IntergalacticMicrosystems/Victor9000-RAM-r2/README.md

# Victor9000-RAM-r2

WORK IN PROGRESS ~ DO NOT USE YET

The Victor9000-RAM-r2 is an attempt to modernize the design for cheaper manufacturing.

Jumper JP1 open is for use on a 256k motherboard, and JP1 closed is for a 128k motherboard.
