IntergalacticMicrosystems/Victor9000-RAM-r2/Victor9000-RAM-r2.routed.png

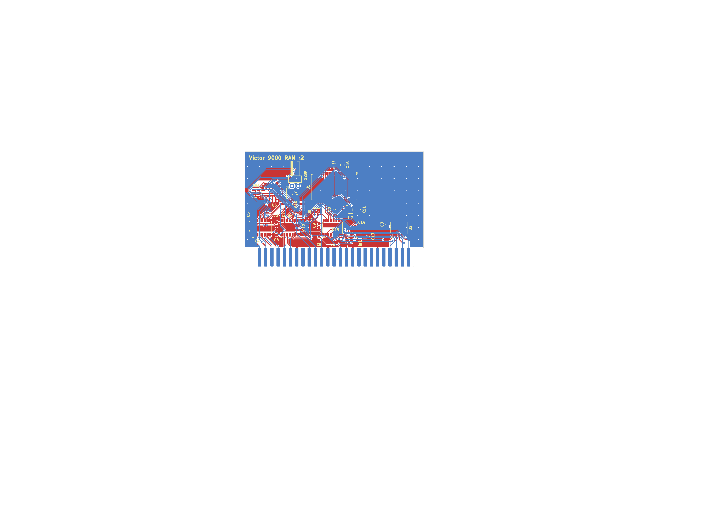
Victor9000-RAM-r2.routed.png
