IntergalacticMicrosystems/Victor9000-RAM-r2/Victor9000-RAM-r2.pdf

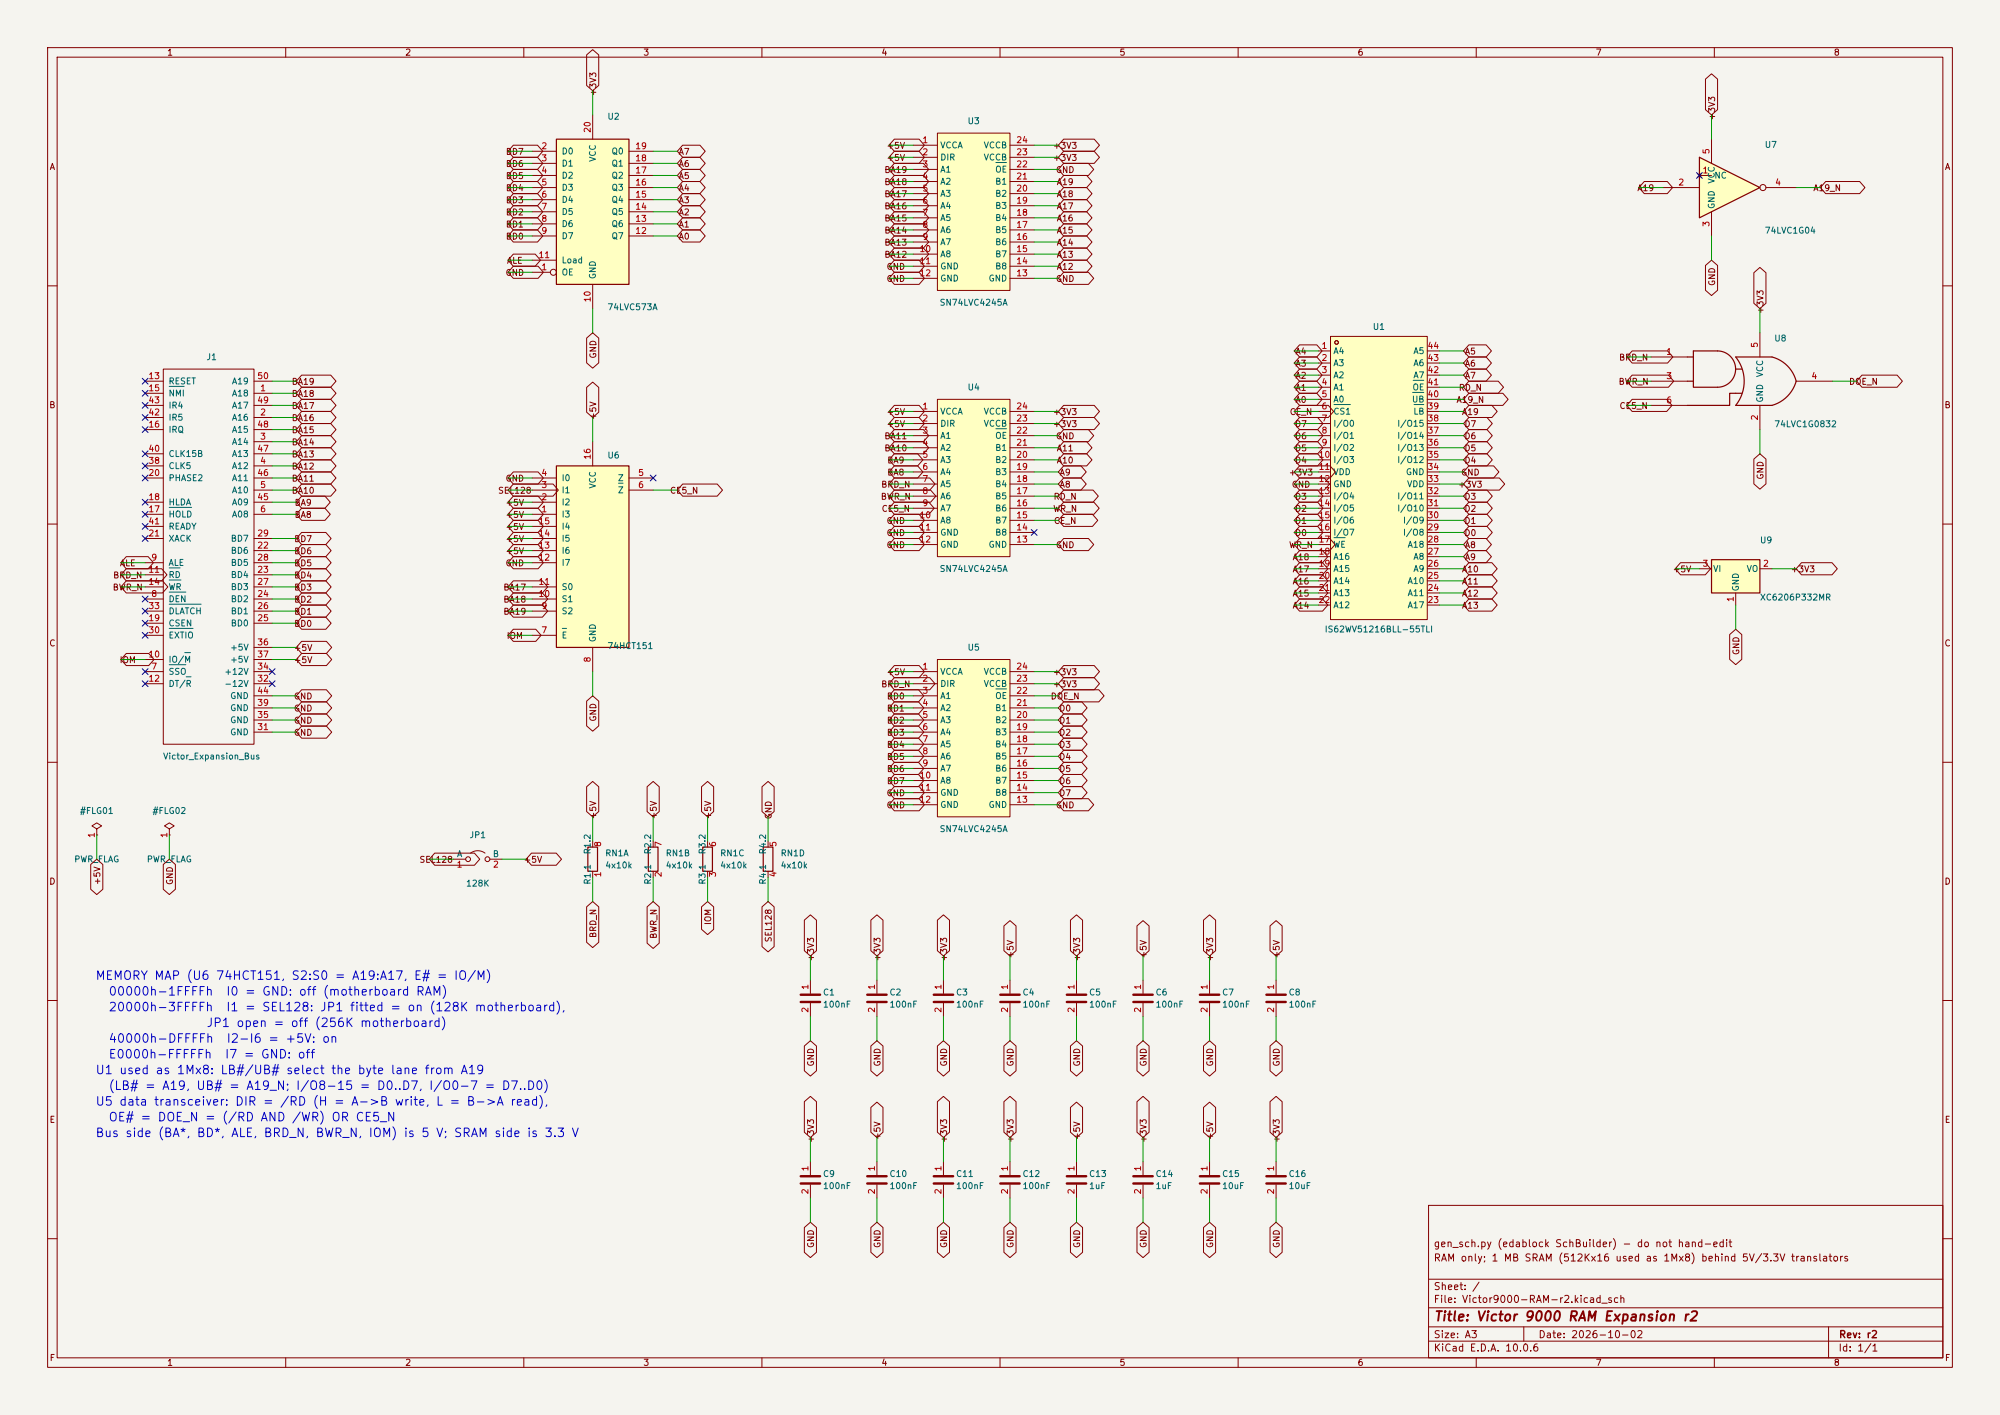
[picture p2: page 1]

MEMORY MAP (U6 74HCT151, S2:S0 = A19:A17, E# = IO/M)
00000h-1FFFFh I0 = GND: off (motherboard RAM)
20000h-3FFFFh I1 = SEL128: JP1 fitted = on (128K motherboard),

40000h-DFFFFh I2-I6 = +5V: on
E0000h-FFFFFh I7 = GND: off
U1 used as 1Mx8: LB#/UB# select the byte lane from A19
U5 data transceiver: DIR = /RD (H = A->B write, L = B->A read),
OE# = DOE_N = (/RD AND /WR) OR CE5_N
Bus side (BA*, BD*, ALE, BRD_N, BWR_N, IOM) is 5 V; SRAM side is 3.3 V

RAM only; 1 MB SRAM (512Kx16 used as 1Mx8) behind 5V/3.3V translators

Sheet: /
File: Victor9000-RAM-r2.kicad_sch
Title: Victor 9000 RAM Expansion r2

Size: A3 | Rev: r2 | F Date: 2026-10-02
KiCad E.D.A. 10.0.6 | Id: 1/1
