IntergalacticMicrosystems/Victor9000-RAM-r2/Victor9000-RAM-r2.kicad_pcb

## KiCad design Victor9000-RAM-r2.kicad_pcb (2026-10-10)

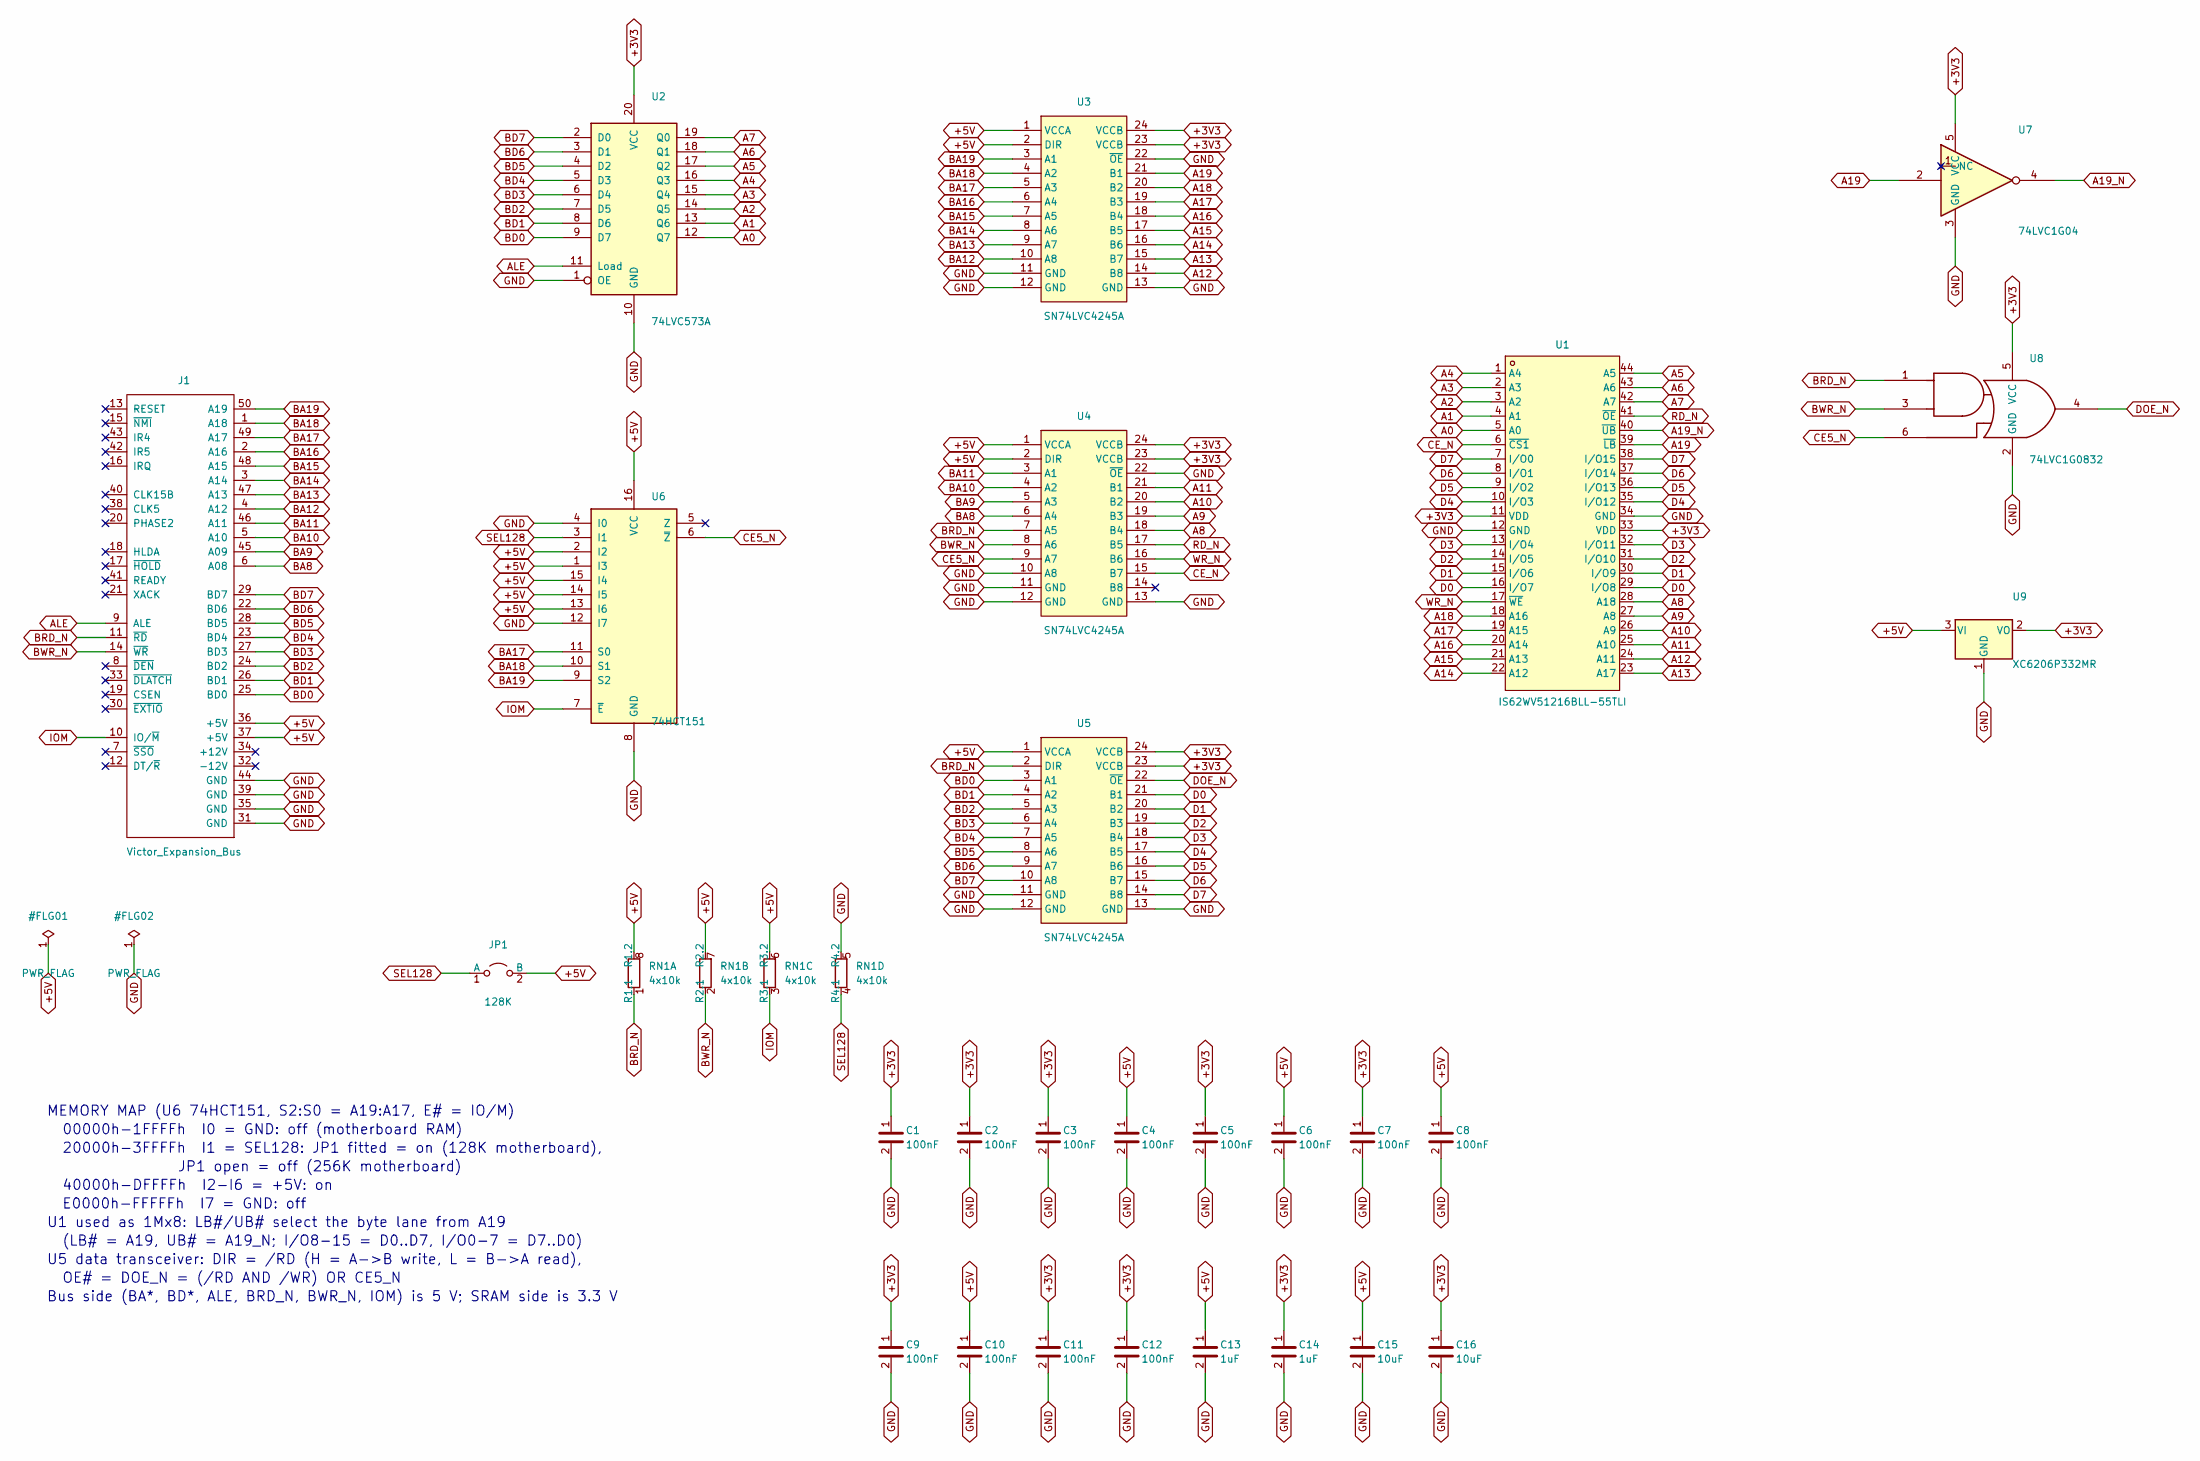
[picture p3: schematic Victor9000-RAM-r2.kicad_sch, Victor 9000 RAM Expansion r2]

Parts:
C1, C2, C3, C4, C5, C6, C7, C8, C9, C10, C11, C12: 100nF; C_0603_1608Metric; MPN CC0603KRX7R9BB104; LCSC C14663
C13, C14: 1uF; C_0603_1608Metric; MPN CL10A105KB8NNNC; LCSC C15849
C15, C16: 10uF; C_0805_2012Metric; MPN CL21A106KAYNNNE; LCSC C15850
J1: Victor_Expansion_Bus; Victor Expansion Edge Connector; MPN card-edge fingers
JP1: 128K; PinHeader_1x02_P2.54mm_Horizontal; MPN PZ254R-11-02P; LCSC C492410
RN1: 4x10k; R_Array_Convex_4x0603; MPN 4D03WGJ0103T5E; LCSC C29718
U1: IS62WV51216BLL-55TLI; TSOP-II-44_10.16x18.41mm_P0.8mm; MPN IS62WV51216BLL-55TLI; LCSC C11315
U2: 74LVC573A; TSSOP-20_4.4x6.5mm_P0.65mm; MPN 74LVC573APW,118; LCSC C6096
U3, U4, U5: SN74LVC4245A; TSSOP-24_4.4x7.8mm_P0.65mm; MPN SN74LVC4245APWR; LCSC C7859
U6: 74HCT151; SOIC-16_3.9x9.9mm_P1.27mm; MPN 74HCT151D,653; LCSC C547364
U7: 74LVC1G04; SOT-23-5; MPN SN74LVC1G04DBVR; LCSC C19829658
U8: 74LVC1G0832; SOT-23-6; MPN SN74LVC1G0832DBVR; LCSC C206101
U9: XC6206P332MR; SOT-23; MPN XC6206P332MR-G; LCSC C5446

Connections:
+3V3: C1.1, C2.1, C3.1, C5.1, C7.1, C9.1, C11.1, C12.1, C14.1, C16.1, U1.11 (VDD), U1.33 (VDD), U2.20 (VCC), U3.23 (VCCB), U3.24 (VCCB), U4.23 (VCCB), U4.24 (VCCB), U5.23 (VCCB), U5.24 (VCCB), U7.5 (VCC), U8.5 (VCC), U9.2 (VO)
+5V: C4.1, C6.1, C8.1, C10.1, C13.1, C15.1, J1.36 (+5V), J1.37 (+5V), JP1.2 (B), RN1.6 (R3.2), RN1.7 (R2.2), RN1.8 (R1.2), U3.1 (VCCA), U3.2 (DIR), U4.1 (VCCA), U4.2 (DIR), U5.1 (VCCA), U6.1 (I3), U6.2 (I2), U6.13 (I6), U6.14 (I5), U6.15 (I4), U6.16 (VCC), U9.3 (VI)
A0: U1.5 (A0), U2.12 (Q7)
A1: U1.4 (A1), U2.13 (Q6)
A2: U1.3 (A2), U2.14 (Q5)
A3: U1.2 (A3), U2.15 (Q4)
A4: U1.1 (A4), U2.16 (Q3)
A5: U1.44 (A5), U2.17 (Q2)
A6: U1.43 (A6), U2.18 (Q1)
A7: U1.42 (A7), U2.19 (Q0)
A8: U1.28 (A18), U4.18 (B4)
A9: U1.27 (A8), U4.19 (B3)
A10: U1.26 (A9), U4.20 (B2)
A11: U1.25 (A10), U4.21 (B1)
A12: U1.24 (A11), U3.14 (B8)
A13: U1.23 (A17), U3.15 (B7)
A14: U1.22 (A12), U3.16 (B6)
A15: U1.21 (A13), U3.17 (B5)
A16: U1.20 (A14), U3.18 (B4)
A17: U1.19 (A15), U3.19 (B3)
A18: U1.18 (A16), U3.20 (B2)
A19: U1.39 (~LB), U3.21 (B1), U7.2
A19_N: U1.40 (~UB), U7.4
ALE: J1.9 (ALE), U2.11 (Load)
BA8: J1.6 (A08), U4.6 (A4)
BA9: J1.45 (A09), U4.5 (A3)
BA10: J1.5 (A10), U4.4 (A2)
BA11: J1.46 (A11), U4.3 (A1)
BA12: J1.4 (A12), U3.10 (A8)
BA13: J1.47 (A13), U3.9 (A7)
BA14: J1.3 (A14), U3.8 (A6)
BA15: J1.48 (A15), U3.7 (A5)
BA16: J1.2 (A16), U3.6 (A4)
BA17: J1.49 (A17), U3.5 (A3), U6.11 (S0)
BA18: J1.1 (A18), U3.4 (A2), U6.10 (S1)
BA19: J1.50 (A19), U3.3 (A1), U6.9 (S2)
BD0: J1.25 (BD0), U2.9 (D7), U5.3 (A1)
BD1: J1.26 (BD1), U2.8 (D6), U5.4 (A2)
BD2: J1.24 (BD2), U2.7 (D5), U5.5 (A3)
BD3: J1.27 (BD3), U2.6 (D4), U5.6 (A4)
BD4: J1.23 (BD4), U2.5 (D3), U5.7 (A5)
BD5: J1.28 (BD5), U2.4 (D2), U5.8 (A6)
BD6: J1.22 (BD6), U2.3 (D1), U5.9 (A7)
BD7: J1.29 (BD7), U2.2 (D0), U5.10 (A8)
BRD_N: J1.11 (~RD), RN1.1 (R1.1), U4.7 (A5), U5.2 (DIR), U8.1
BWR_N: J1.14 (~WR), RN1.2 (R2.1), U4.8 (A6), U8.3
CE5_N: U4.9 (A7), U6.6 (~Z), U8.6
CE_N: U1.6 (~CS1), U4.15 (B7)
D0: U1.16 (I/O7), U1.29 (I/O8), U5.21 (B1)
D1: U1.15 (I/O6), U1.30 (I/O9), U5.20 (B2)
D2: U1.14 (I/O5), U1.31 (I/O10), U5.19 (B3)
D3: U1.13 (I/O4), U1.32 (I/O11), U5.18 (B4)
D4: U1.10 (I/O3), U1.35 (I/O12), U5.17 (B5)
D5: U1.9 (I/O2), U1.36 (I/O13), U5.16 (B6)
D6: U1.8 (I/O1), U1.37 (I/O14), U5.15 (B7)
D7: U1.7 (I/O0), U1.38 (I/O15), U5.14 (B8)
DOE_N: U5.22 (~OE), U8.4
GND: C1.2, C2.2, C3.2, C4.2, C5.2, C6.2, C7.2, C8.2, C9.2, C10.2, C11.2, C12.2, C13.2, C14.2, C15.2, C16.2, J1.31 (GND), J1.35 (GND), J1.39 (GND), J1.44 (GND), RN1.5 (R4.2), U1.12 (GND), U1.34 (GND), U2.1 (OE), U2.10 (GND), U3.11 (GND), U3.12 (GND), U3.13 (GND), U3.22 (~OE), U4.10 (A8), U4.11 (GND), U4.12 (GND), U4.13 (GND), U4.22 (~OE), U5.11 (GND), U5.12 (GND), U5.13 (GND), U6.4 (I0), U6.8 (GND), U6.12 (I7), U7.3 (GND), U8.2 (GND), U9.1 (GND)
IOM: J1.10 (IO/~M), RN1.3 (R3.1), U6.7 (~E)
RD_N: U1.41 (~OE), U4.17 (B5)
SEL128: JP1.1 (A), RN1.4 (R4.1), U6.3 (I1)
WR_N: U1.17 (~WE), U4.16 (B6)

Notes on the sheet:
MEMORY MAP (U6 74HCT151, S2:S0 = A19:A17, E# = IO/M)
00000h-1FFFFh I0 = GND: off (motherboard RAM)
20000h-3FFFFh I1 = SEL128: JP1 fitted = on (128K motherboard),
JP1 open = off (256K motherboard)
40000h-DFFFFh I2-I6 = +5V: on
E0000h-FFFFFh I7 = GND: off
U1 used as 1Mx8: LB#/UB# select the byte lane from A19
(LB# = A19, UB# = A19_N; I/O8-15 = D0..D7, I/O0-7 = D7..D0)
U5 data transceiver: DIR = /RD (H = A->B write, L = B->A read),
OE# = DOE_N = (/RD AND /WR) OR CE5_N
Bus side (BA*, BD*, ALE, BRD_N, BWR_N, IOM) is 5 V; SRAM side is 3.3 V

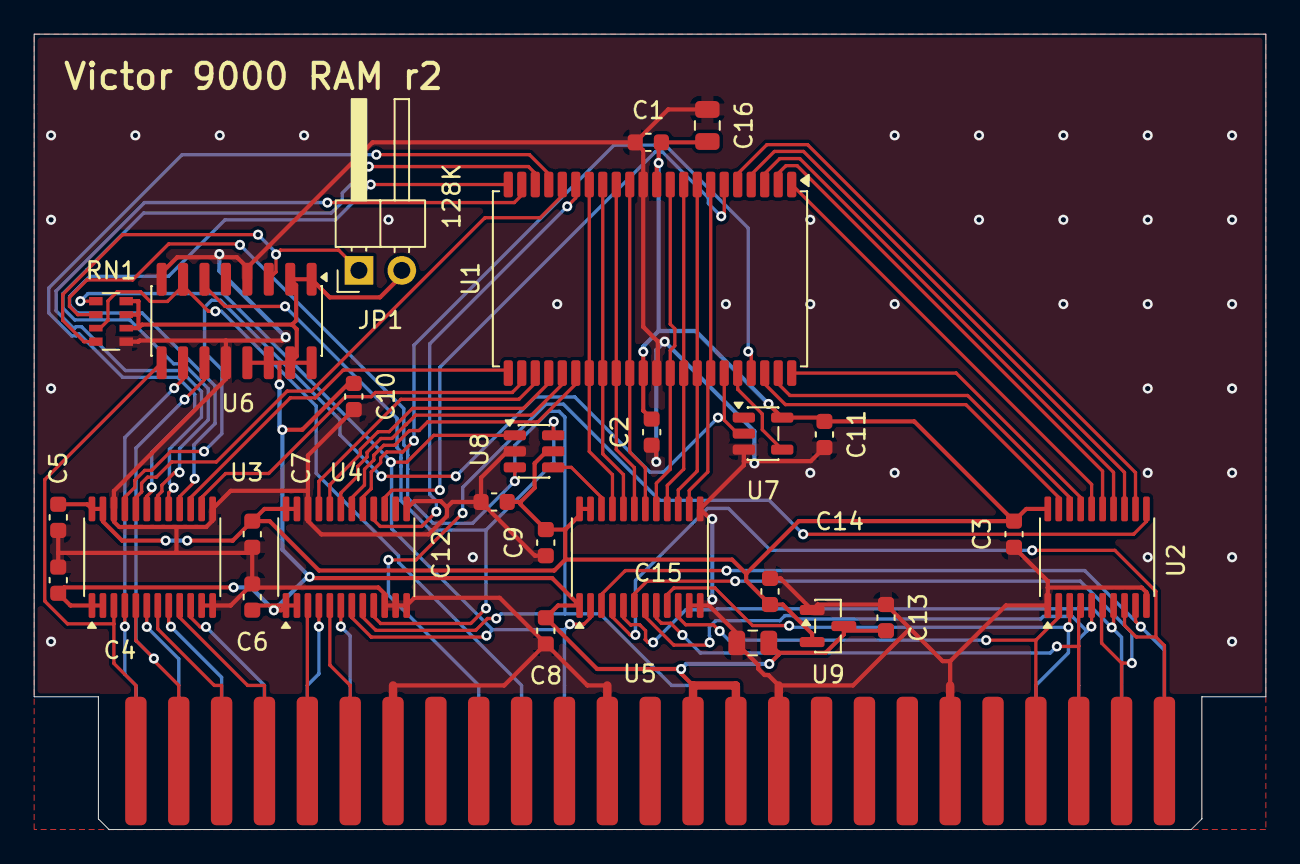
[picture p4: board Victor9000-RAM-r2.kicad_pcb from above]

Board: 2 copper layers, 73.0 x 47.1 mm, 28 parts (0 on the bottom side), 62 nets.
